T0mmy312/Breaklight/Hardware/Battery/Docs.md

The Samsung INR21700-50S was chosen because it combines high capacity (5000 mAh) with high current capability (up to 30 A), reliably covering both energy-demanding and high-power applications.

\[batterielink](https://enerprof.de/products/samsung-sdi-li-ion-zelle-inr21700-50s-21700-5000-mah-6c)
