T0mmy312/Breaklight/Rules.md

# Rules

- Everything is in English.
- Everything Code/Naming is Cammel case.
- Moast Folders must contain a Docs.md file and Research folder where a running documentation is held.
- All docs are in Markdown (final documentation in LaTeX).
- All indents are Tabs.
- All functions should have a descriptive comment.
- When singular changes are encapsulated in one commit you should pull -> commit -> push and when it is a longer process you should branch -> commit (until finished) -> merge.
- commit messages should be descriptive.
