T0mmy312/Breaklight/Hardware/Case/Research/baseCaseDrawing.png

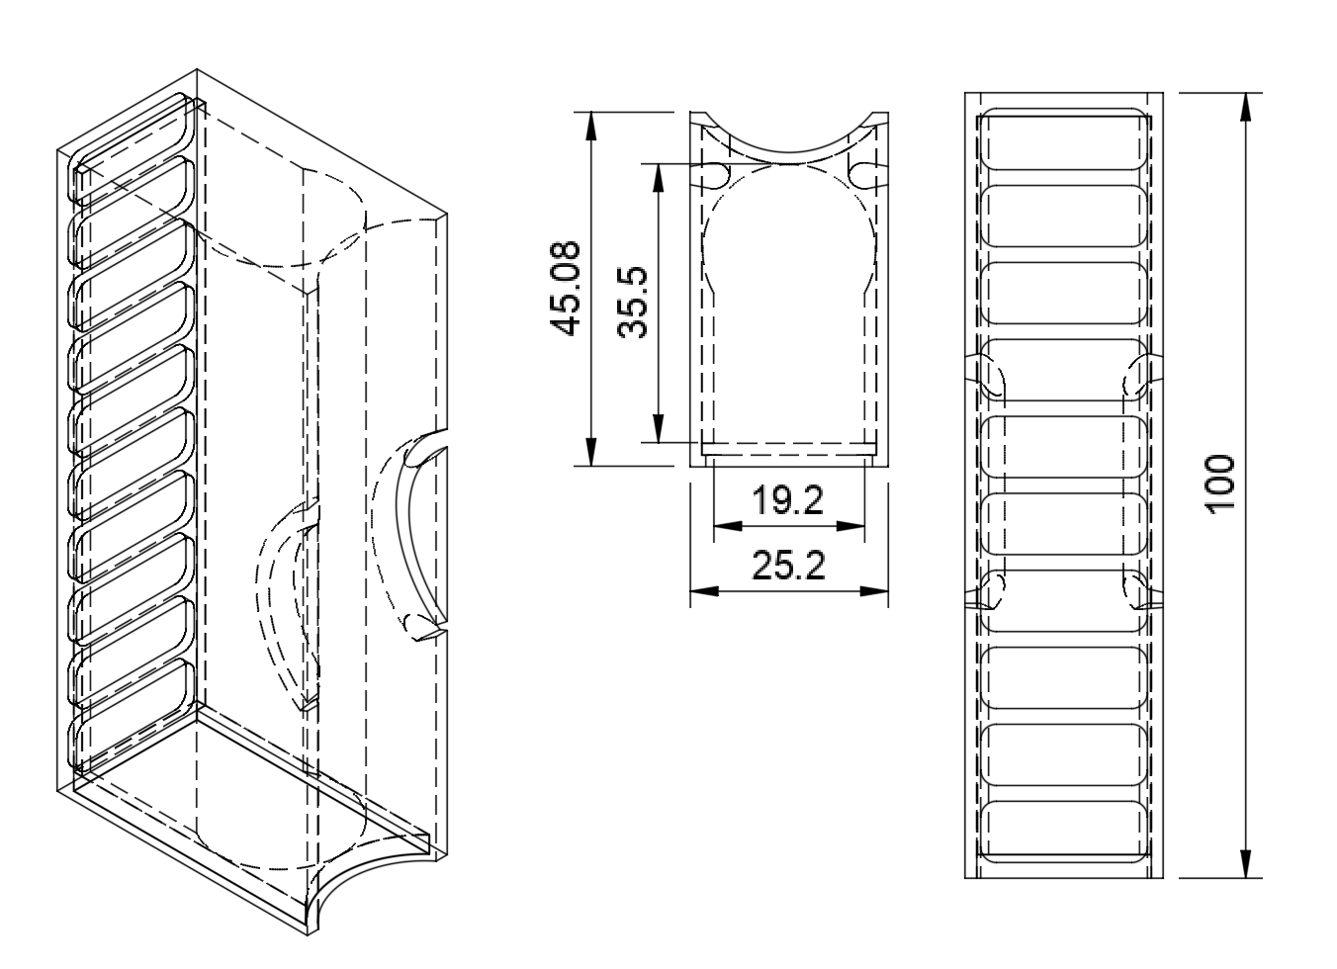
Hardware/Case/Research/baseCaseDrawing.png
