T0mmy312/Breaklight/(list of files, cad)

Other CAD files:
Hardware/Case/case.f3d
