T0mmy312/Breaklight/Hardware/ChargingPort/12401936_x1 (1).pdf

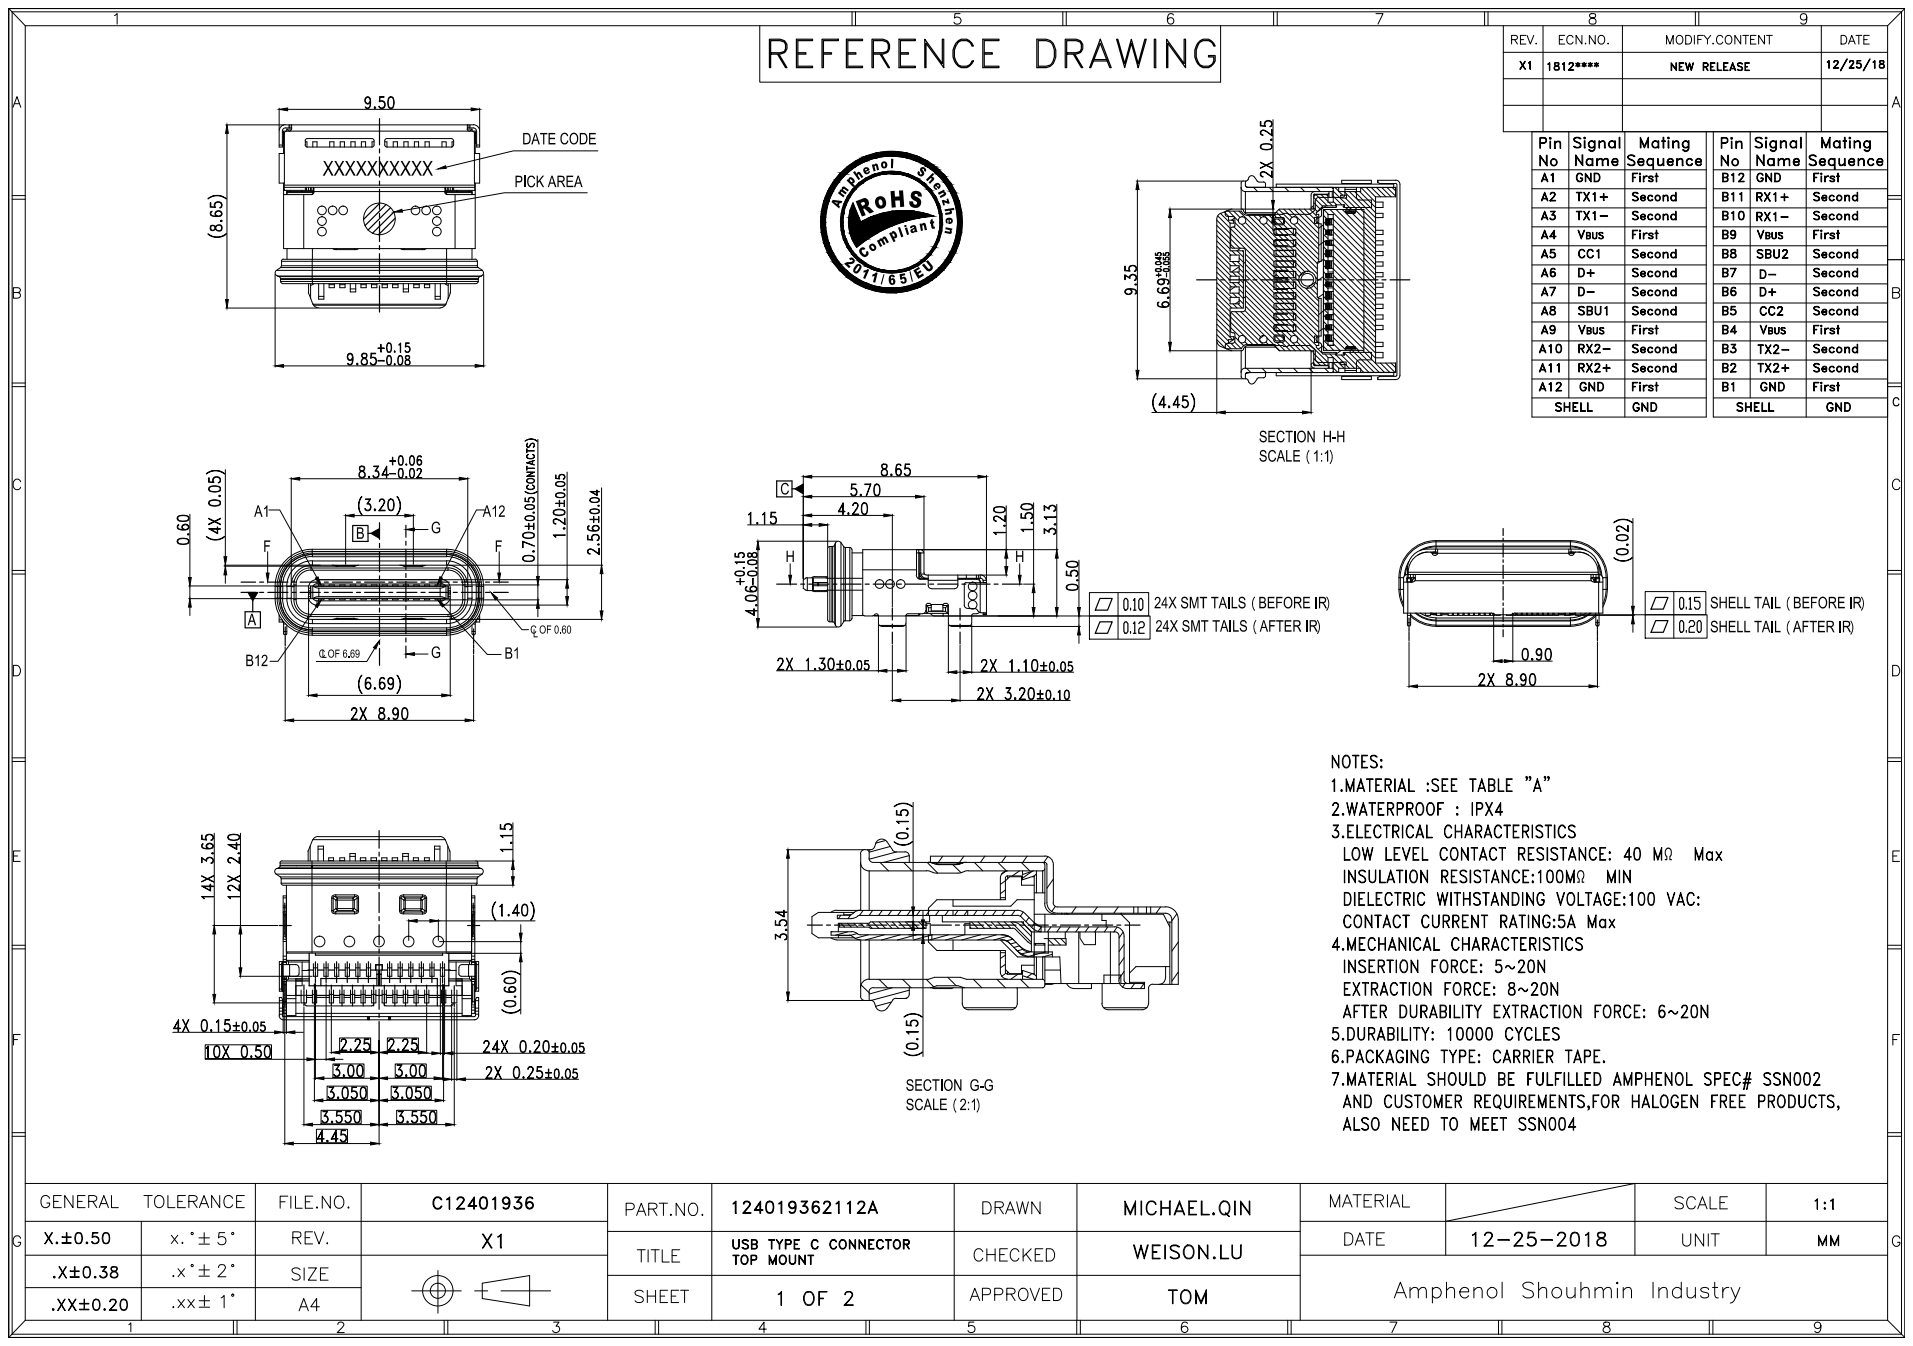
[picture p2: page 1]

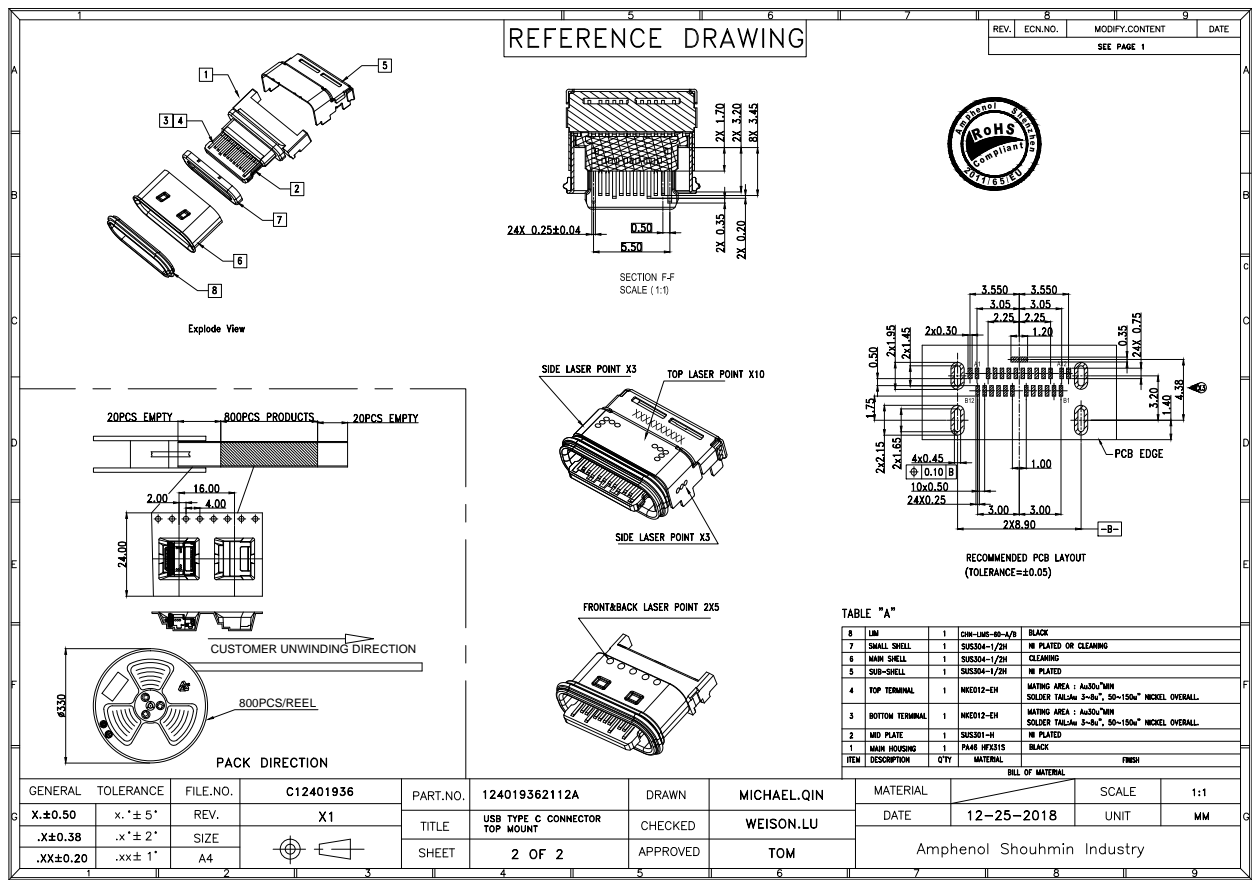
[picture p3: page 2]

CUSTOMER UNWINDING DIRECTION 800PCS/REEL
