T0mmy312/Breaklight/Hardware/PCB/Dynamo/schaltplan_layout/Dynamo_circiut.kicad_pcb

## KiCad design Hardware/PCB/Dynamo/schaltplan_layout/Dynamo_circiut.kicad_pcb (2025-11-17)

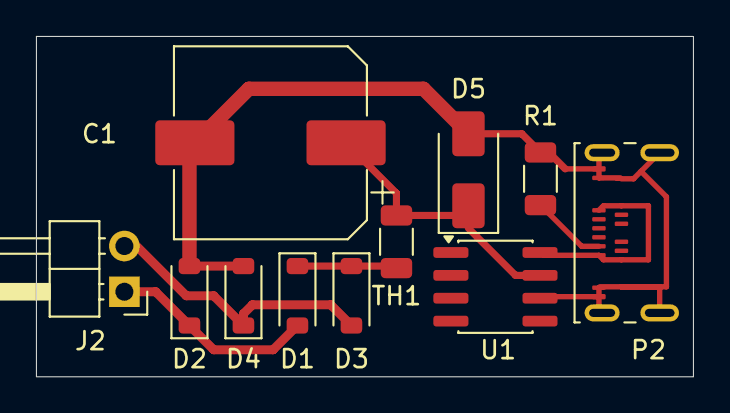
[picture p4: board Dynamo_circiut.kicad_pcb from above]

Board: 2 copper layers, 36.5 x 18.9 mm, 11 parts (0 on the bottom side), 7 nets.

Parts:
C1: 470µ; CP_Elec_10x10.5
D1, D2, D3, D4: 1N5819; D_SOD-123
D5: SMAJ30A; D_SMA
J2: Conn_01x02_Socket; PinHeader_1x02_P2.54mm_Horizontal
P2: USB_C_Plug_USB2.0; USB_C_Receptacle_Amphenol_124019772112A
R1: 5.1k; R_1206_3216Metric
TH1: Littelfuse 1206L050WR; R_1206_3216Metric
U1: LM2594HVM-5.0; SOIC-8_3.9x4.9mm_P1.27mm

Connections:
/Dynamo: D3.2 (A), D4.1 (K), J2.2
/Dynamo_minus: D1.2 (A), D2.1 (K), J2.1
unnamed: D1.1 (K), D3.1 (K), TH1.2
unnamed: C1.2, D2.2 (A), D4.2 (A), D5.2 (A2), P2.A1 (GND), P2.A12 (GND), P2.B1 (GND), P2.B12 (GND), P2.S1 (SHIELD), R1.2, U1.6 (GND)
unnamed: C1.1, D5.1 (A1), TH1.1, U1.7 (VIN)
unnamed: P2.A5 (CC), R1.1
unnamed: P2.A4 (VBUS), P2.A9 (VBUS), P2.B4 (VBUS), P2.B9 (VBUS), U1.8 (OUT)
