T0mmy312/Breaklight/Hardware/PCB/Final_V1/Final_PCB/Final_PCB.kicad_pcb

## KiCad design Hardware/PCB/Final_V1/Final_PCB/Final_PCB.kicad_pcb (2025-11-24)

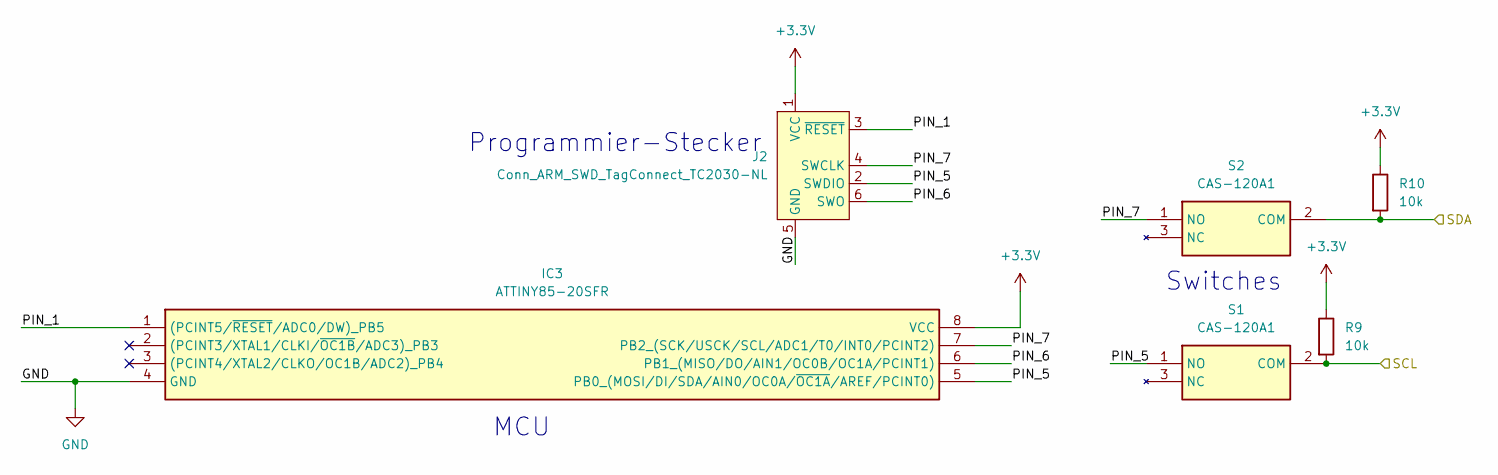
[picture p5: schematic attiny.kicad_sch]

Parts:
IC3: ATTINY85-20SFR; SOIC127P798X216-8N; Mouser Part Number 556-ATTINY85-20SFR
J2: Conn_ARM_SWD_TagConnect_TC2030-NL; Tag-Connect_TC2030-IDC-NL_2x03_P1.27mm_Vertical
R9, R10: 10k; R_0603_1608Metric
S1, S2: CAS-120A1; CAS120A1; Mouser Part Number 229-CAS-120A1

Connections:
+3.3V: IC3.8 (VCC), J2.1 (VCC), R9.1, R10.1; also elsewhere on the board
/ATTiny/PIN_1: IC3.1 ((PCINT5/~RESET/ADC0/DW)_PB5), J2.3 (~RESET)
/ATTiny/PIN_5: IC3.5 (PB0_(MOSI/DI/SDA/AIN0/OC0A/~OC1A/AREF/P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), J2.2 (SWDIO), S1.1 (NO)
/ATTiny/PIN_6: IC3.6 (PB1_(MISO/DO/AIN1/OC0B/OC1A/PCINT1)), J2.6 (SWO)
/ATTiny/PIN_7: IC3.7 (PB2_(SCK/USCK/SCL/ADC1/T0/INT0/PCINT2)), J2.4 (SWCLK), S2.1 (NO)
/ATTiny/SCL: R9.2, S1.2 (COM); also elsewhere on the board
/ATTiny/SDA: R10.2, S2.2 (COM); also elsewhere on the board
GND: IC3.4 (GND), J2.5 (GND); also elsewhere on the board

Notes on the sheet:
Switches
Programmier-Stecker
MCU

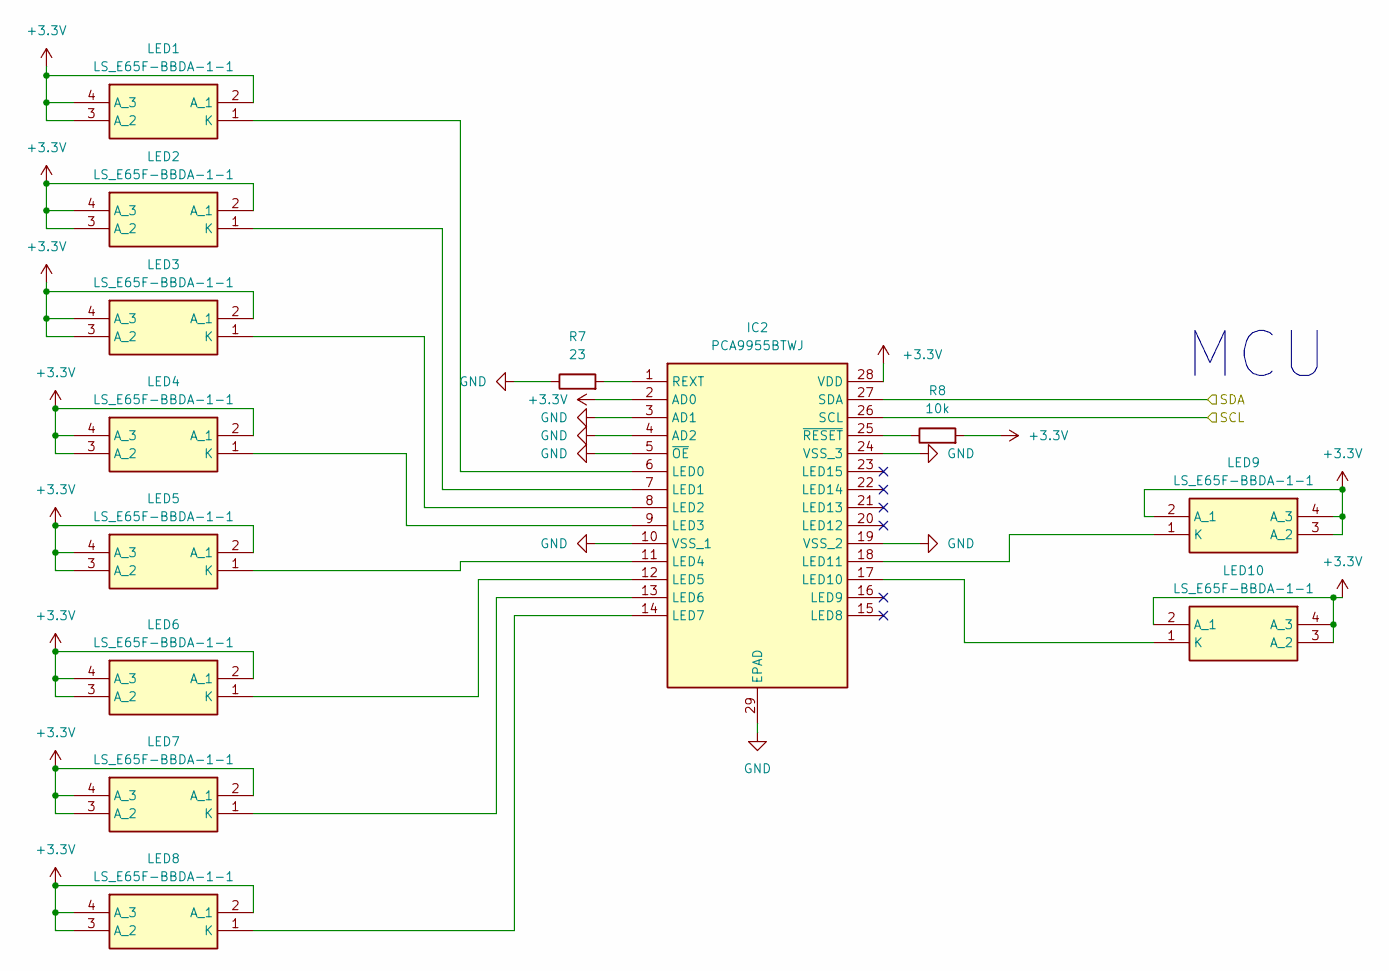
[picture p6: schematic Led_Driver.kicad_sch]

Parts:
IC2: PCA9955BTWJ; SOP65P640X110-29N; Manufacturer_Part_Number PCA9955BTWJ
LED1, LED2, LED3, LED4, LED5, LED6, LED7, LED8, LED9, LED10: LS_E65F-BBDA-1-1; LSE65FBBDA11; Mouser Part Number 720-LSE65F-BBDA-1-Z
R7: 23; R_0603_1608Metric
R8: 10k; R_0603_1608Metric

Connections:
+3.3V: IC2.2 (AD0), IC2.28 (VDD), LED1.2 (A_1), LED1.3 (A_2), LED1.4 (A_3), LED2.2 (A_1), LED2.3 (A_2), LED2.4 (A_3), LED3.2 (A_1), LED3.3 (A_2), LED3.4 (A_3), LED4.2 (A_1), LED4.3 (A_2), LED4.4 (A_3), LED5.2 (A_1), LED5.3 (A_2), LED5.4 (A_3), LED6.2 (A_1), LED6.3 (A_2), LED6.4 (A_3), LED7.2 (A_1), LED7.3 (A_2), LED7.4 (A_3), LED8.2 (A_1), LED8.3 (A_2), LED8.4 (A_3), LED9.2 (A_1), LED9.3 (A_2), LED9.4 (A_3), LED10.2 (A_1), LED10.3 (A_2), LED10.4 (A_3), R8.2; also elsewhere on the board
/ATTiny/SCL: IC2.26 (SCL); also elsewhere on the board
/ATTiny/SDA: IC2.27 (SDA); also elsewhere on the board
GND: IC2.3 (AD1), IC2.4 (AD2), IC2.5 (~OE), IC2.10 (VSS_1), IC2.19 (VSS_2), IC2.24 (VSS_3), IC2.29 (EPAD), R7.1; also elsewhere on the board
unnamed: IC2.6 (LED0), LED1.1 (K)
unnamed: IC2.7 (LED1), LED2.1 (K)
unnamed: IC2.8 (LED2), LED3.1 (K)
unnamed: IC2.9 (LED3), LED4.1 (K)
unnamed: IC2.11 (LED4), LED5.1 (K)
unnamed: IC2.12 (LED5), LED6.1 (K)
unnamed: IC2.13 (LED6), LED7.1 (K)
unnamed: IC2.14 (LED7), LED8.1 (K)
unnamed: IC2.17 (LED10), LED10.1 (K)
unnamed: IC2.18 (LED11), LED9.1 (K)
unnamed: IC2.1 (REXT), R7.2
unnamed: IC2.25 (~RESET), R8.1

Notes on the sheet:
MCU

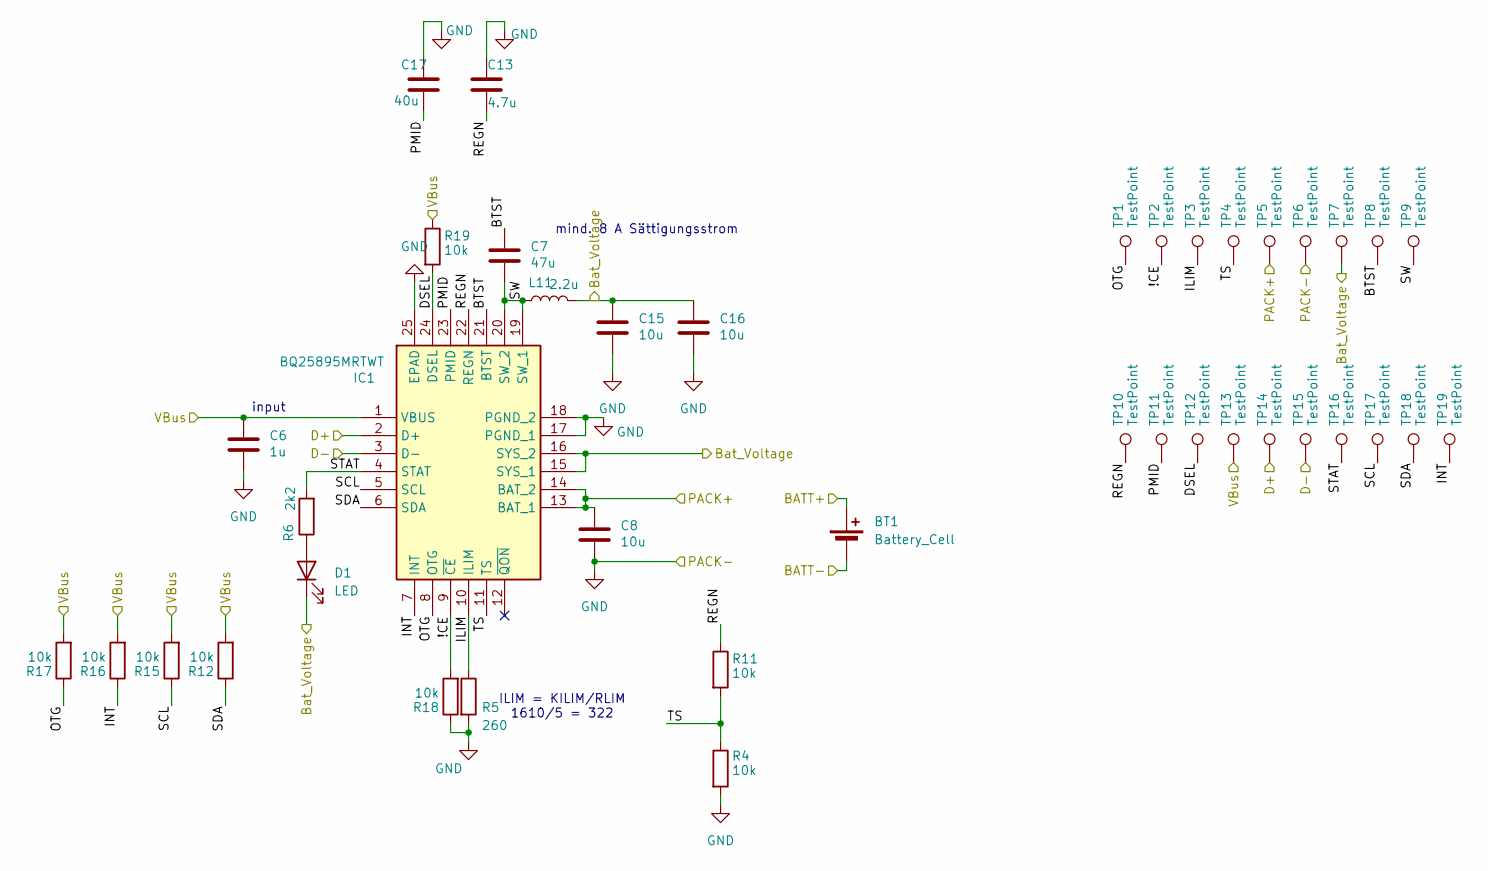
[picture p7: schematic BQ25895M.kicad_sch]

Parts:
BT1: Battery_Cell; PinHeader_1x02_P2.54mm_Vertical
C6: 1u; C_0603_1608Metric
C7: 47u; C_0603_1608Metric
C8, C15, C16: 10u; C_0603_1608Metric
C13: 4.7u; C_0603_1608Metric
C17: 40u; C_0603_1608Metric
D1: LED; LED_0603_1608Metric
IC1: BQ25895MRTWT; QFN50P400X400X80-25N-D; Mouser Part Number 595-BQ25895MRTWT
L11: 2.2u; L_0603_1608Metric
R4, R11, R12, R15, R16, R17, R18, R19: 10k; R_0603_1608Metric
R5: 260; R_0603_1608Metric
R6: 2k2; R_0603_1608Metric
TP1, TP2, TP3, TP4, TP5, TP6, TP7, TP8, TP9, TP10, TP11, TP12, TP13, TP14, TP15, TP16, TP17, TP18, TP19: TestPoint; TestPoint_Pad_1.5x1.5mm

Connections:
/BMS/BATT+: BT1.1 (+); also elsewhere on the board
/BMS/PACK+: C8.1, IC1.13 (BAT_1), IC1.14 (BAT_2), TP5.1; also elsewhere on the board
/BQ25895M/!CE: IC1.9 (~CE), R18.2, TP2.1
/BQ25895M/BTST: C7.1, IC1.21 (BTST), TP8.1
/BQ25895M/Bat_Voltage: C15.1, C16.1, D1.1 (K), IC1.15 (SYS_1), IC1.16 (SYS_2), L11.2, TP7.1; also elsewhere on the board
/BQ25895M/D+: IC1.2 (D+), TP14.1; also elsewhere on the board
/BQ25895M/D-: IC1.3 (D-), TP15.1; also elsewhere on the board
/BQ25895M/DSEL: IC1.24 (DSEL), R19.2, TP12.1
/BQ25895M/ILIM: IC1.10 (ILIM), R5.1, TP3.1
/BQ25895M/INT: IC1.7 (INT), R16.1, TP19.1
/BQ25895M/OTG: IC1.8 (OTG), R17.1, TP1.1
/BQ25895M/PMID: C17.2, IC1.23 (PMID), TP11.1
/BQ25895M/REGN: C13.2, IC1.22 (REGN), R11.1, TP10.1
/BQ25895M/SCL: IC1.5 (SCL), R15.1, TP17.1
/BQ25895M/SDA: IC1.6 (SDA), R12.1, TP18.1
/BQ25895M/STAT: IC1.4 (STAT), R6.2, TP16.1
/BQ25895M/SW: C7.2, IC1.19 (SW_1), IC1.20 (SW_2), L11.1, TP9.1
/BQ25895M/TS: IC1.11 (TS), R4.1, R11.2, TP4.1
/BQ25895M/VBus: C6.1, IC1.1 (VBUS), R12.2, R15.2, R16.2, R17.2, R19.1, TP13.1; also elsewhere on the board
GND: BT1.2 (-), C6.2, C8.2, C13.1, C15.2, C16.2, C17.1, IC1.17 (PGND_1), IC1.18 (PGND_2), IC1.25 (EPAD), R4.2, R5.2, R18.1, TP6.1; also elsewhere on the board
unnamed: D1.2 (A), R6.1

Notes on the sheet:
ILIM = KILIM/RLIM 1610/5 = 322
mind. 8 A Sättigungsstrom
input

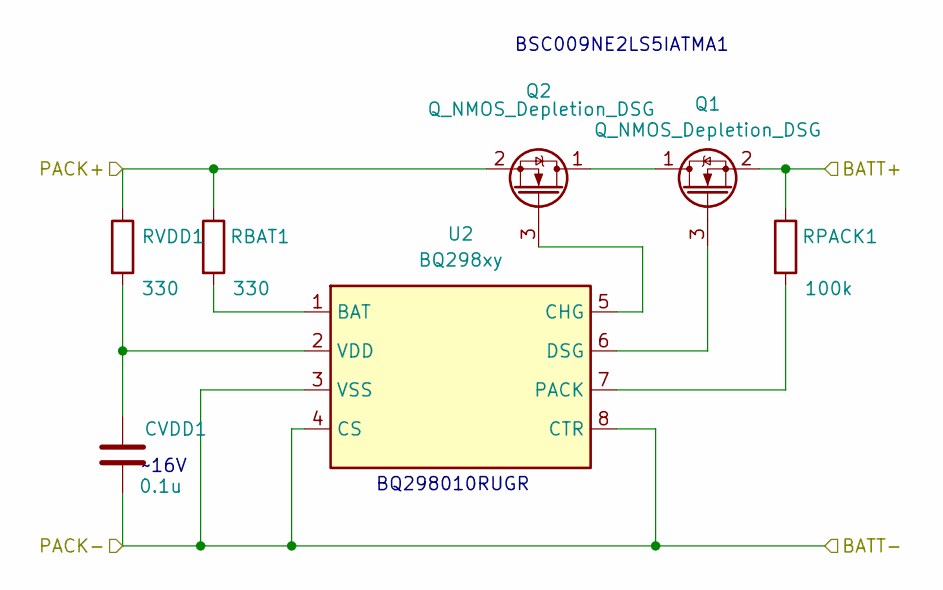
[picture p8: schematic BMS.kicad_sch]

Parts:
CVDD1: 0.1u; C_0603_1608Metric_Pad1.08x0.95mm_HandSolder
Q1, Q2: Q_NMOS_Depletion_DSG; MOSFET_BSC093N04LSGATMA1
RBAT1: 330; R_0603_1608Metric
RPACK1: 100k; R_0603_1608Metric
RVDD1: 330; R_0603_1608Metric
U2: BQ298xy; QFN50P150X150X40-8N

Connections:
/BMS/BATT+: Q1.2 (S), RPACK1.1; also elsewhere on the board
/BMS/PACK+: Q2.2 (S), RBAT1.1, RVDD1.1; also elsewhere on the board
GND: CVDD1.2, U2.3 (VSS), U2.4 (CS), U2.8 (CTR); also elsewhere on the board
unnamed: Q1.1 (D), Q2.1 (D)
unnamed: Q1.3 (G), U2.6 (DSG)
unnamed: Q2.3 (G), U2.5 (CHG)
unnamed: RBAT1.2, U2.1 (BAT)
unnamed: RPACK1.2, U2.7 (PACK)
unnamed: CVDD1.1, RVDD1.2, U2.2 (VDD)

Notes on the sheet:
BSC009NE2LS5IATMA1
~16V
BQ298010RUGR

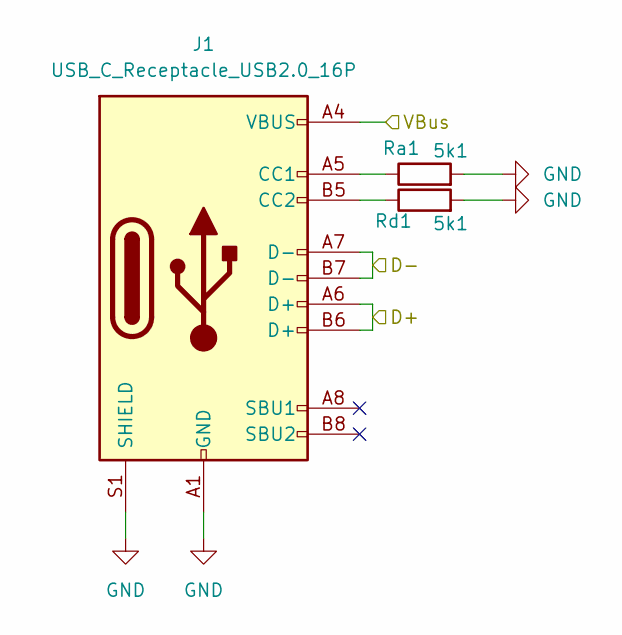
[picture p9: schematic USB-c.kicad_sch]

Parts:
J1: USB_C_Receptacle_USB2.0_16P; USB_C_Receptacle_GCT_USB4085
Ra1: 5k1; R_0603_1608Metric
Rd1: 5k1; R_0603_1608Metric

Connections:
/BQ25895M/D+: J1.A6 (D+), J1.B6 (D+); also elsewhere on the board
/BQ25895M/D-: J1.A7 (D-), J1.B7 (D-); also elsewhere on the board
/BQ25895M/VBus: J1.A4 (VBUS), J1.A9 (VBUS), J1.B4 (VBUS), J1.B9 (VBUS); also elsewhere on the board
GND: J1.A1 (GND), J1.A12 (GND), J1.B1 (GND), J1.B12 (GND), J1.S1 (SHIELD), Ra1.2, Rd1.2; also elsewhere on the board
unnamed: J1.A5 (CC1), Ra1.1
unnamed: J1.B5 (CC2), Rd1.1

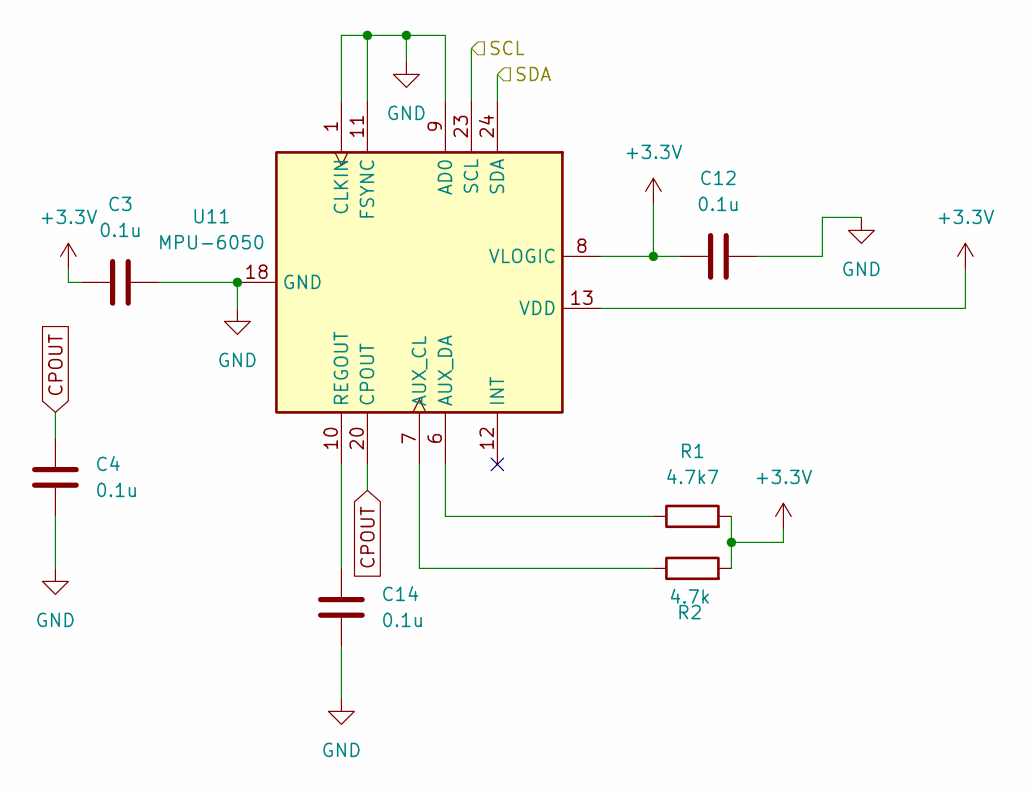
[picture p10: schematic Gyro.kicad_sch]

Parts:
C3, C4, C12, C14: 0.1u; C_0603_1608Metric_Pad1.08x0.95mm_HandSolder
R1: 4.7k7; R_0603_1608Metric
R2: 4.7k; R_0603_1608Metric
U11: MPU-6050; InvenSense_QFN-24_4x4mm_P0.5mm

Connections:
+3.3V: C3.1, C12.1, R1.2, R2.2, U11.8 (VLOGIC), U11.13 (VDD); also elsewhere on the board
/ATTiny/SCL: U11.23 (SCL); also elsewhere on the board
/ATTiny/SDA: U11.24 (SDA); also elsewhere on the board
CPOUT: C4.2, U11.20 (CPOUT)
GND: C3.2, C4.1, C12.2, C14.2, U11.1 (CLKIN), U11.9 (AD0), U11.11 (FSYNC), U11.18 (GND); also elsewhere on the board
unnamed: R2.1, U11.7 (AUX_CL)
unnamed: R1.1, U11.6 (AUX_DA)
unnamed: C14.1, U11.10 (REGOUT)

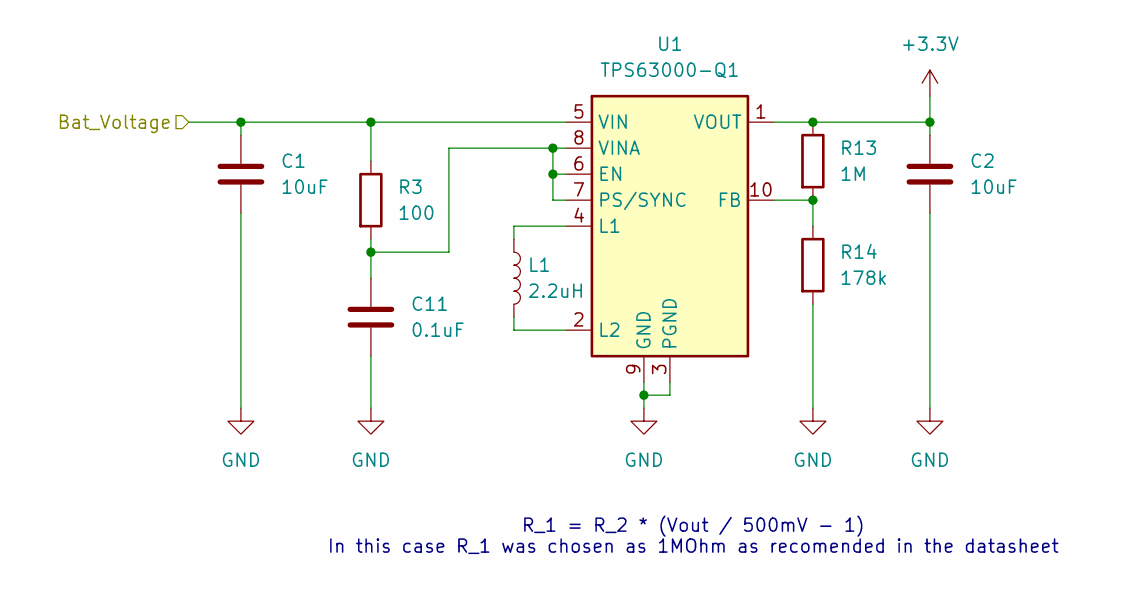
[picture p11: schematic Spannungsregler.kicad_sch]

Parts:
C1, C2: 10uF; C_0603_1608Metric
C11: 0.1uF; C_0603_1608Metric
L1: 2.2uH; L_0805_2012Metric
R3: 100; R_0603_1608Metric
R13: 1M; R_0603_1608Metric
R14: 178k; R_0603_1608Metric
U1: TPS63000-Q1; Texas_DRC0010J_ThermalVias

Connections:
+3.3V: C2.1, R13.1, U1.1 (VOUT); also elsewhere on the board
/BQ25895M/Bat_Voltage: C1.1, R3.1, U1.5 (VIN); also elsewhere on the board
GND: C1.2, C2.2, C11.2, R14.2, U1.3 (PGND), U1.9 (GND), U1.11 (PGND); also elsewhere on the board
unnamed: C11.1, R3.2, U1.6 (EN), U1.7 (PS/SYNC), U1.8 (VINA)
unnamed: R13.2, R14.1, U1.10 (FB)
unnamed: L1.1, U1.4 (L1)
unnamed: L1.2, U1.2 (L2)

Notes on the sheet:
R_1 = R_2 * (Vout / 500mV - 1) In this case R_1 was chosen as 1MOhm as recomended in the datasheet

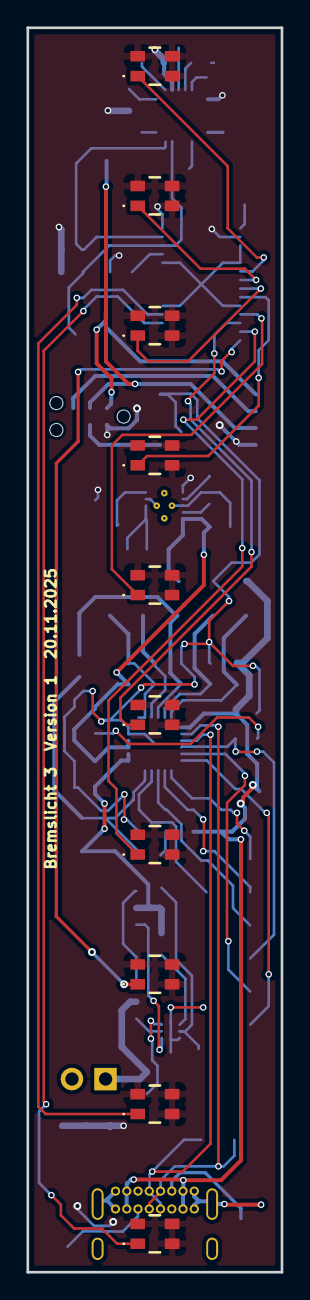
[picture p12: board Final_PCB.kicad_pcb from above]

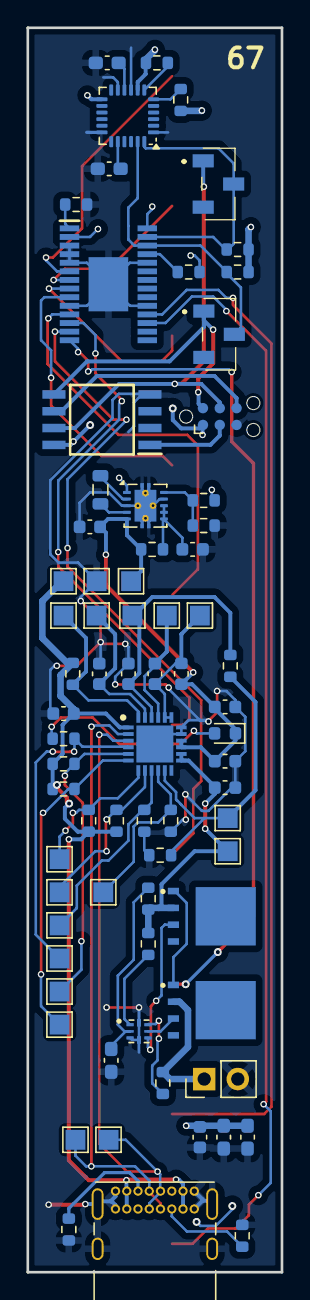
[picture p13: board Final_PCB.kicad_pcb from below]

Board: 2 copper layers, 19.2 x 94.0 mm, 84 parts (74 on the bottom side), 56 nets.
