T0mmy312/Breaklight/Hardware/PCB/RechargeBattery/RechargeBatteryV3.kicad_sch

## KiCad design Hardware/PCB/RechargeBattery/RechargeBatteryV3.kicad_sch (2025-10-14)

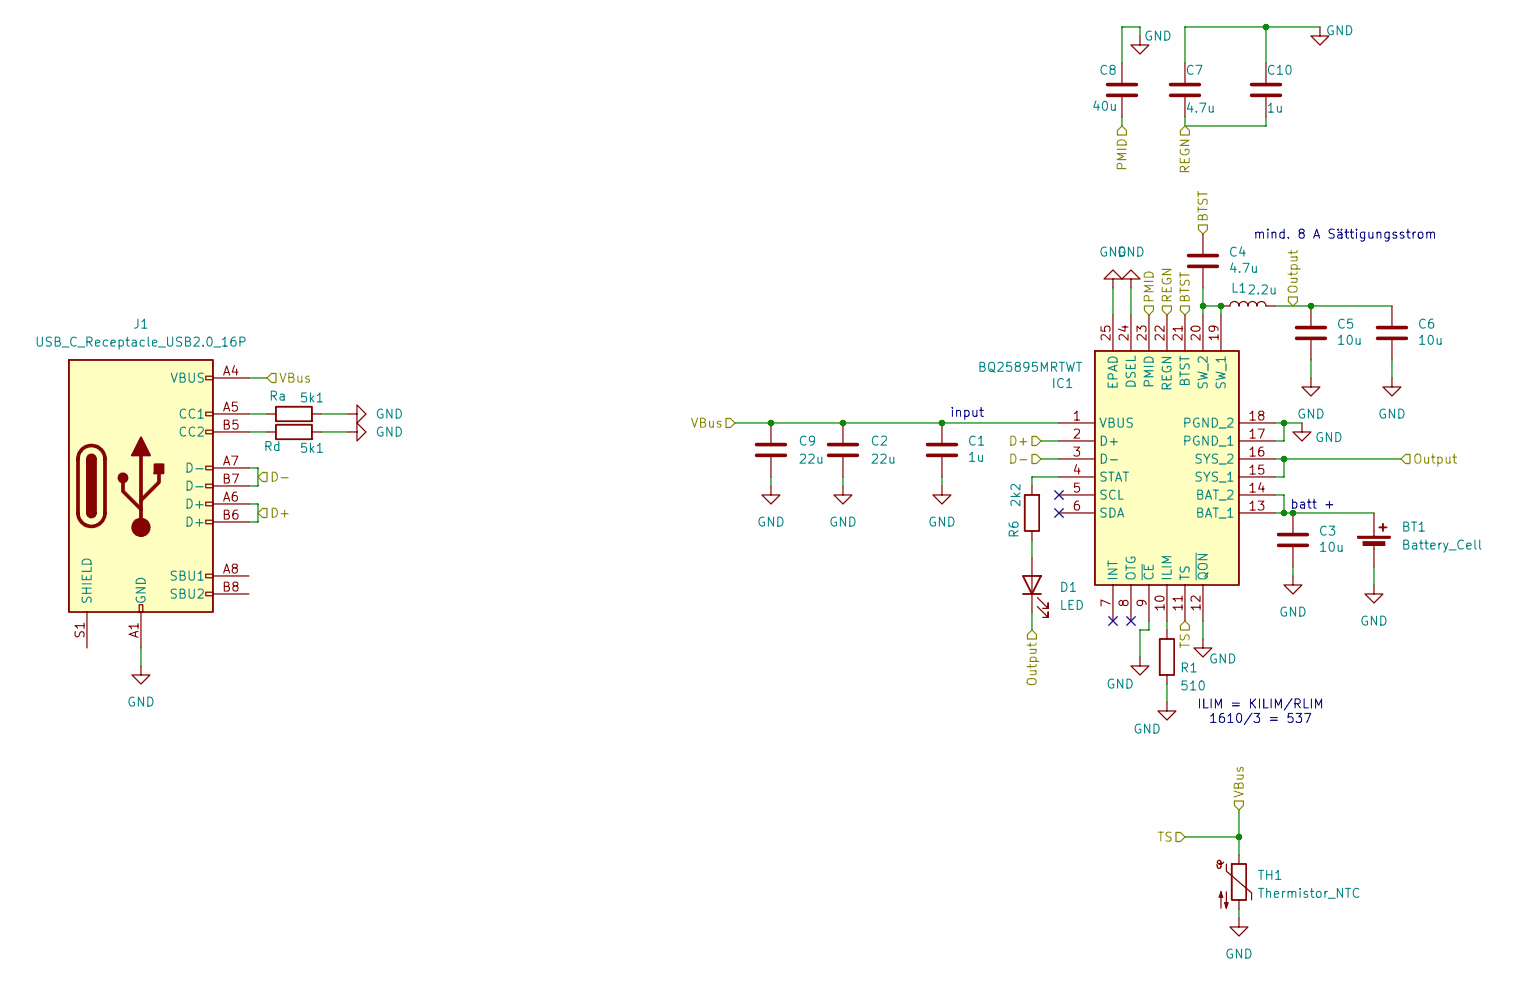
[picture p14: schematic RechargeBatteryV3.kicad_sch]

Parts:
BT1: Battery_Cell
C1, C10: 1u; C_0603_1608Metric
C2, C9: 22u; C_0603_1608Metric
C3, C5, C6: 10u; C_0603_1608Metric
C4, C7: 4.7u; C_0603_1608Metric
C8: 40u; C_0603_1608Metric
D1: LED
IC1: BQ25895MRTWT; QFN50P400X400X80-25N-D; Mouser Part Number 595-BQ25895MRTWT
J1: USB_C_Receptacle_USB2.0_16P; USB_C_Receptacle_GCT_USB4085
L1: 2.2u; L_0603_1608Metric
R1: 510; R_0603_1608Metric
R6: 2k2; R_0603_1608Metric
Ra: 5k1; R_0603_1608Metric
Rd: 5k1; R_0603_1608Metric
TH1: Thermistor_NTC

Connections:
BTST: C4.1, IC1.21 (BTST)
D+: IC1.2 (D+), J1.A6 (D+), J1.B6 (D+)
D-: IC1.3 (D-), J1.A7 (D-), J1.B7 (D-)
GND: BT1.2 (-), C1.2, C2.2, C3.2, C5.2, C6.2, C7.1, C8.1, C9.2, C10.1, IC1.9 (~CE), IC1.12 (~QON), IC1.17 (PGND_1), IC1.18 (PGND_2), IC1.24 (DSEL), IC1.25 (EPAD), J1.A1 (GND), J1.A12 (GND), J1.B1 (GND), J1.B12 (GND), R1.2, Ra.2, Rd.2, TH1.2
unnamed: BT1.1 (+), C3.1, IC1.13 (BAT_1), IC1.14 (BAT_2)
unnamed: C4.2, IC1.19 (SW_1), IC1.20 (SW_2), L1.1
unnamed: D1.2 (A), R6.1
unnamed: IC1.4 (STAT), R6.2
unnamed: IC1.10 (ILIM), R1.1
unnamed: J1.A5 (CC1), Ra.1
unnamed: J1.B5 (CC2), Rd.1
Output: C5.1, C6.1, D1.1 (K), IC1.15 (SYS_1), IC1.16 (SYS_2), L1.2
PMID: C8.2, IC1.23 (PMID)
REGN: C7.2, C10.2, IC1.22 (REGN)
TS: C1.1, C2.1, C9.1, IC1.1 (VBUS), IC1.11 (TS), J1.A4 (VBUS), J1.A9 (VBUS), J1.B4 (VBUS), J1.B9 (VBUS), TH1.1

Notes on the sheet:
ILIM = KILIM/RLIM 1610/3 = 537
mind. 8 A Sättigungsstrom
input
batt +
