T0mmy312/Breaklight/(commit log)

2025-09-22 initial research for SMD-LEDs
2025-09-22 added another LED option doc
2025-09-22 format update docs for LED
2025-09-22 made a charcing circut. that works with our usb-c connctor and our battery
2025-09-22 changed batterie to Battery
2025-09-22 added mcu research and led driver ic in the docs
2025-09-22 Research Gyro
2025-09-22 added base case design and technical drawing
    [case.f3d]
2025-09-29 added PCB-outline
2025-10-06 Recharge Batterie V1
    [RechargeBattery.kicad_pcb, RechargeBattery.kicad_sch, RechargeBatteryV2.kicad_pcb, RechargeBatteryV2.kicad_sch]
2025-10-06 Create GYRO_Shematic
2025-10-06 Recharge Batterie V2
    [RechargeBattery.kicad_pcb, RechargeBattery.kicad_sch, RechargeBatteryV2.kicad_pcb, RechargeBatteryV2.kicad_sch]
2025-10-14 added a doc.md for the charcing port where I descriped why we picked it
    [RechargeBatteryV3.kicad_pcb, RechargeBatteryV3.kicad_sch]
2025-10-14 batterie recharing system V3 with BQ25895M chip
    [RechargeBatteryV3.kicad_pcb]
2025-10-14 minor refactoring
    [RechargeBatteryV3.kicad_pcb, RechargeBatteryV3.kicad_sch]
2025-10-20 rechargeBatterie schematic finsished
    [BMS.kicad_sch, BQ25895M.kicad_sch, RechargeBatteryV3.kicad_pcb, RechargeBatteryV3.kicad_sch, USB-c.kicad_sch]
2025-10-20 added Led_Driver and Documentation
    [Led_Driver.kicad_pcb, Led_Driver.kicad_sch]
2025-10-20 move Gyro-Folder
    [projekt_gyro.kicad_pcb, projekt_gyro.kicad_sch]
2025-10-30 finished schematic
    [BMS.kicad_sch, BQ25895M.kicad_sch, Battery.kicad_sch, Final_PCB.kicad_pcb, Final_PCB.kicad_sch, Gyro.kicad_sch, Led_Driver.kicad_sch, USB-c.kicad_sch]
2025-11-03 fixed Schematics
    [Final_PCB.kicad_sch, Led_Driver.kicad_sch, attiny.kicad_sch]
2025-11-03 added Voltage regulator to get constant 3.3V Voltage and fixed some issues
    [BQ25895M.kicad_sch, EDI2CAP.CFG, Gyro.kicad_sch, INDC2016X180N.PcbLib, LBM2016T2R2J.SchLib, LBM2016T2R2J.stp, Spannungsregler.kicad_pcb, Spannungsregler.kicad_sch]
2025-11-03 fixed last commit, because it was wrong
    [Final_PCB.kicad_sch, Spannungsregler.kicad_sch, attiny.kicad_sch]
2025-11-03 fixing xhematics
    [BQ25895M.kicad_sch, Final_PCB.kicad_sch, Gyro.kicad_sch, Led_Driver.kicad_sch, Spannungsregler.kicad_sch, attiny.kicad_sch]
2025-11-10 fixed curcuit, mainly the charge curcuit
    [Led_Driver.kicad_sch]
2025-11-16 #1: Add footprints to the components
    [BQ25895M.kicad_sch, Final_PCB.kicad_pcb, Gyro.kicad_sch, Led_Driver.kicad_sch, attiny.kicad_sch]
2025-11-17 added footprints for BQ298010RUGR and BSC009NE2LS5IATMA1
    [BMS.kicad_sch, Final_PCB.kicad_pcb]
2025-11-17 #2: fix 2 footprints
2025-11-17 started layouting
    [BMS.kicad_sch, Final_PCB.kicad_pcb, Led_Driver.kicad_sch]
2025-11-17 #3: fix-1-footprint
    [BQ25895M.kicad_sch, Gyro.kicad_sch]
2025-11-17 reapplied fixes because of commiting problems
    [BMS.kicad_sch, BQ25895M.kicad_sch, Gyro.kicad_sch, Spannungsregler.kicad_sch]
2025-11-17 fixed some minor mistakes and added test pads for the battery charger
    [BQ25895M.kicad_sch, Final_PCB.csv, Spannungsregler.kicad_sch]
2025-11-17 #4: Layout-Session-17-11-25
    [BMS.kicad_sch, BQ25895M.kicad_sch, Final_PCB.kicad_pcb, Gyro.kicad_sch, Spannungsregler.kicad_sch]
2025-11-22 #5: finish layout
    [Final_PCB.kicad_pcb, Final_PCB.kicad_sch]
2025-11-23 made a few pcb tweaks
    [Final_PCB.kicad_pcb]
2025-11-23 Devre kartının çalışmasını ummalıyız
    [Final_PCB.kicad_pcb]
2025-11-23 a few pcb edits
    [BQ25895M.kicad_sch, Final_PCB.kicad_pcb]
2025-11-24 add pcb fixes
    [Final_PCB.kicad_pcb]
2025-12-01 added project structure
    [BMS.kicad_sch, BQ25895M.kicad_sch, Dynamo_circiut.kicad_pcb, Dynamo_circiut.kicad_sch, EDI2CAP.CFG, INDC2016X180N.PcbLib, LBM2016T2R2J.SchLib, LBM2016T2R2J.stp]
